joyshmitz/PLFM_RADAR/4_Schematics and Boards Layout/4_7_Production Files/Gerber_Patch_Antenna/BOM_Patch_Antenna.xlsx

Qty | Value | Device | Package | Parts | Description | MANUFACTURER_PART_NUMBER
11 | 142-0731-211 | 142-0731-211 | 1420731211 | J1, J2, J3, J4, J5, J6, J7, J8, J9, J10, J11, J12, J13, J14, J15, J17 | SMA Connector Jack, Female Socket 50 Ohms Through Hole Solder | 142-0731-211
