joyshmitz/PLFM_RADAR/4_Schematics and Boards Layout/4_7_Production Files/Gerber_freq_synth/BOM_Freq_Synth.xlsx

Qty | Value | Device | Package | Parts | Description | MANUFACTURER_PART_NUMBER
5 |  | L-EUL5650M | L5650M | L9, L10, L11, L12, L13 | INDUCTOR, European symbol | HI2220P601R-10
1 |  | PINHD-2X6 | 2X06 | JP1 | PIN HEADER | 87834-1211 (https://eu.mouser.com/ProductDetail/Molex/87834-1211?qs=kNSQ05%252BLZoDv7br%252B0FPisw%3D%3D)
1 |  | PINHD-2X7 | 2X07 | JP2 | PIN HEADER | 90130-1314 (https://eu.mouser.com/ProductDetail/Molex/90130-1314?qs=kEwmkoUtv7Q0tkiQKJqMSw%3D%3D)
28 | 0.1µF | C-EUC0201 | C0201 | C16, C18, C20, C22, C24, C26, C28, C30, C32, C34, C35, C36, C37, C41, C42, C43, C44, C64, C65, C66, C67, C87, C88, C90, C91, C4, C5, C7 | CAPACITOR, European symbol | CL03A104KP3NNNH
1 | 0.1µf | C-EUC0201 | C0201 | C92 | CAPACITOR, European symbol | CL03A104KP3NNNH
2 | 0.33µF | C-EUC0201 | C0201 | C2, C6 | CAPACITOR, European symbol | 0201X334M6R3CT (https://eu.mouser.com/ProductDetail/Walsin/0201X334M6R3CT?qs=iLbezkQI%252Bsj6TtN1Mk8apQ%3D%3D)
2 | 0.47µF | C-EUC0201 | C0201 | C9, C10 | CAPACITOR, European symbol | CL03A474KP3NNNC
1 | 0.47µf | C-EUC0201 | C0201 | C3 | CAPACITOR, European symbol | CL03A474KP3NNNC
3 | 0.65k | R-EU_R0201 | R0201 | R6, R8, R10 | RESISTOR, European symbol | CPF0201B649RE1 (https://eu.mouser.com/ProductDetail/TE-Connectivity-Holsworthy/CPF0201B649RE1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)
9 | 0R | R-EU_R0201 | R0201 | R5, R14, R15, R19, R20, R27, R28, R32, R33 | RESISTOR, European symbol | RCA02010000ZSEDSR
8 | 1.3nH | L-USL0201 | L0201 | L1, L2, L3, L4, L5, L6, L7, L8 | INDUCTOR, American symbol | LQP03HQ1N3W02D (https://eu.mouser.com/ProductDetail/Murata-Electronics/LQP03HQ1N3W02D?qs=B6kkDfuK7%2FBCgkEUu6f9mw%3D%3D)
1 | 1000pF | C-EUC0201 | C0201 | C8 | CAPACITOR, European symbol | CL03B102KA3NNNC
4 | 100R | R-EU_R0201 | R0201 | R1, R12, R13, R26 | RESISTOR, European symbol | RC0201FR-07100RL
2 | 10nF | C-EUC0201 | C0201 | C61, C84 | CAPACITOR, European symbol | 0201B103K250NT
3 | 10nF | C-EUC0402 | C0402 | C15, C17, C19 | CAPACITOR, European symbol | GRM1555CYA103GE01J (https://eu.mouser.com/ProductDetail/Murata-Electronics/GRM1555CYA103GE01J?qs=d0WKAl%252BL4KbA7gCogz12ew%3D%3D)
6 | 10pF | C-EUC0201 | C0201 | C1, C62, C63, C85, C86, C89 | CAPACITOR, European symbol | CL03C100JA3GNNC
5 | 10µF | C-EUC1210 | C1210 | C23, C27, C31, C45, C47 | CAPACITOR, European symbol | MBASU32MAB7106KPNA01 (https://eu.mouser.com/ProductDetail/TAIYO-YUDEN/MBASU32MAB7106KPNA01?qs=tlsG%2FOw5FFjbKuqA1IZNFA%3D%3D)
11 | 142-0731-211 | 142-0731-211 | 1420731211 | J1, J2, J5, J6, J7, J8, J9, J10, J11, J12, J13 | SMA Connector Jack, Female Socket 50 Ohms Through Hole Solder | 142-0731-211
6 | 1k | R-EU_R0201 | R0201 | R2, R3, R4, R7, R9, R11 | RESISTOR, European symbol | 1-2176072-2 (https://eu.mouser.com/ProductDetail/TE-Connectivity-Holsworthy/1-2176072-2?qs=TqB%2FzLOUcHJkUvL3%2FB9tYg%3D%3D)
10 | 1µF | C-EUC0201 | C0201 | C11, C12, C13, C14, C59, C68, C69, C70, C71, C82 | CAPACITOR, European symbol | CL03A105MQ3CSNH
8 | 200k | R-EU_R0201 | R0201 | R22, R23, R24, R25, R35, R36, R37, R38 | RESISTOR, European symbol | RE0201BRE07200KL (https://eu.mouser.com/ProductDetail/YAGEO/RE0201BRE07200KL)
6 | 22-23-2021 | 22-23-2021 | 22-23-2021 | X10, X11, X12, X13, X14, X15 | .100 (2.54mm) Center Header - 2 Pin" | 22-23-2021
3 | 22R | R-EU_R0201 | R0201 | R39, R40, R41 | RESISTOR, European symbol | RT0201FRE0722RL (https://eu.mouser.com/ProductDetail/YAGEO/RT0201FRE0722RL)
6 | 22µF | C-EUC1210 | C1210 | C21, C25, C29, C33, C46, C51 | CAPACITOR, European symbol | MAAST32MSB7226MPNA01 (https://eu.mouser.com/ProductDetail/TAIYO-YUDEN/MAAST32MSB7226MPNA01?qs=FmjOKN4Os876lp2kR04m7Q%3D%3D)
2 | 30R | R-EU_R0201 | R0201 | R17, R30 | RESISTOR, European symbol | ERJ-U01J300C (https://eu.mouser.com/ProductDetail/Panasonic/ERJ-U01J300C)
2 | 31pF | C-EUC0201 | C0201 | C60, C83 | CAPACITOR, European symbol | GCM0335C1H300FA16J (https://eu.mouser.com/ProductDetail/Murata-Electronics/GCM0335C1H300FA16J?qs=5aG0NVq1C4ze9%252Bgr8KZLTg%3D%3D)
2 | 330R | R-EU_R0201 | R0201 | R18, R31 | RESISTOR, European symbol | RC0201FR-7D330RL (https://eu.mouser.com/ProductDetail/YAGEO/RC0201FR-7D330RL?qs=sGAEpiMZZMtlubZbdhIBINSnPd898yDP6M5V2P2FozI%3D)
20 | 4.7µF | C-EUC0201 | C0201 | C38, C39, C40, C48, C49, C50, C55, C56, C57, C58, C72, C73, C74, C75, C76, C77, C78, C79, C80, C81 | CAPACITOR, European symbol | GRM035R60J475ME15D (https://eu.mouser.com/ProductDetail/Murata-Electronics/GRM035R60J475ME15D?qs=I53XXhTNm8vhFCgPvCZ%252BPQ%3D%3D)
2 | 500R | R-EU_R0201 | R0201 | R21, R34 | RESISTOR, European symbol | CPF0201B499RE1 (https://eu.mouser.com/ProductDetail/TE-Connectivity-Holsworthy/CPF0201B499RE1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)
2 | 931R | R-EU_R0201 | R0201 | R16, R29 | RESISTOR, European symbol | CRCW0201931RFKED (https://eu.mouser.com/ProductDetail/Vishay/CRCW0201931RFKED)
1 | AD9523BCPZ | AD9523BCPZ | QFN50P1000X1000X100-73N | IC1 | AD9523BCPZ, PLL Clock Driver Dual, 72-Pin LFCSP VQ | AD9523BCPZ
2 | ADF4382ABCCZ | ADF4382ABCCZ | CC-48-10_ADI | U1, U6 |  | ADF4382ABCCZ
4 | ATS1005-3DB-FD-T05 | ATS1005-3DB-FD-T05 | SMT_DB-FD-T05_SUS | U4, U5, U8, U10 |  | ATS1005-3DB-FD-T05
2 | CJT-T-P-HH-ST-TH1 | CJT-T-P-HH-ST-TH1 | CONN_CJT-T-P-XX-ST-TH1_SAI | J3, J4 |  | CJT-T-P-HH-ST-TH1
2 | CVHD-950-50.000 | CVHD-950-50.000 | SMD4_CVHD-950_CRX | X5, X6 |  | CVHD-950-50.000
1 | ECOC-2522-100.000-3HC | ECOC-2522-100.000-3HC | SMD5_ECOC-2522_25P4X22_ECS | X4 |  | ECOC-2522-100.000-3HC
4 | FBMH1608HL601-T | FBMH1608HL601-T | BEADC1608X90N | FB1, FB2, FB3, FB4 |  | FBMH1608HL601-T
2 | Green | LED-GREEN-0603-WE | LED-0603 | D1, D2 | Green SMD LED | KB EELP41.12-P1R2-36-3X4X-5-R18
4 | MTX2-143+ | MTX2-143+ | DQ1225_MNC | U2, U3, U7, U9 |  | MTX2-143+
