joyshmitz/PLFM_RADAR/4_Schematics and Boards Layout/4_7_Production Files/Gerber_Main_Board/BOM_Main_Board.xlsx

Qty | Value | Device | Package | Parts | Description | MANUFACTURER_PART_NUMBER
11 |  | L-EUL5650M | L5650M | L1, L11, L12, L13, L14, L15, L16, L17, L18, L21, L23 | INDUCTOR, European symbol | HI2220P601R-10
1 |  | MA10-2 | MA10-2 | SV1 | PIN HEADER | MA10-2
1 |  | PINHD-1X2 | 1X02 | JP20 | PIN HEADER | Do Not Put
11 |  | PINHD-1X3 | 1X03 | JP4, JP5, JP6, JP10, JP11, JP12, JP14, JP15, JP16, JP17, JP19 | PIN HEADER | Do Not Put
3 |  | PINHD-1X4 | 1X04 | JP8, JP9, JP18 | PIN HEADER | Do Not Put
1 |  | PINHD-1X6 | 1X06 | JP2 | PIN HEADER | Do Not Put
1 |  | PINHD-1X8 | 1X08 | JP7 | PIN HEADER | Do Not Put
1 |  | PINHD-2X4 | 2X04 | JP3 | PIN HEADER | Do Not Put
1 |  | PINHD-2X6 | 2X06 | JP1 | PIN HEADER | 87834-1211 (https://eu.mouser.com/ProductDetail/Molex/87834-1211?qs=kNSQ05%252BLZoDv7br%252B0FPisw%3D%3D)
1 |  | PINHD-2X7 | 2X07 | JP13 | PIN HEADER | 90130-1314 (https://eu.mouser.com/ProductDetail/Molex/90130-1314?qs=kEwmkoUtv7Q0tkiQKJqMSw%3D%3D)
1 |  | SJ2W | SJ_2 | SJ1 | SMD solder JUMPER | Do Not Put
71 | 0.1uF | CC0201 | C0201 | C1, C2, C4, C5, C6, C7, C8, C9, C10, C11, C12, C13, C14, C15, C16, C36, C38, C39, C41, C42, C44, C45, C46, C47, C51, C52, C53, C56, C67, C69, C74, C80, C82, C125, C131, C133, C138, C140, C146, C148, C159, C160, C162, C168, C170, C175, C188, C189, C190, C192, C193, C194, C195, C196, C201, C203, C208, C210, C215, C217, C222, C224, C229, C231, C236, C238, C243, C245, C250, C252, C293 | CAPACITOR, European symbol | CL03A104KP3NNNH
4 | 0.1uF | C-EUC0402 | C0402 | C48, C49, C57, C58 | CAPACITOR, European symbol | GRM155R71C104KA88D
6 | 0.1uF | CC0201 | C0201 | C277, C278, C295, C297, C299, C301 | CAPACITOR, European symbol | CL03A104KP3NNNH
1 | 0.2pF | C-EUC0201 | C0201 | C43 | CAPACITOR, European symbol | GJM0335C1ER20WB01D
13 | 0.47uF | CC0201 | C0201 | C110, C111, C112, C113, C155, C156, C157, C158, C179, C180, C181, C182, C291 | CAPACITOR, European symbol | CL03A474KP3NNNC
1 | 0.6pF | C-EUC0201 | C0201 | C54 | CAPACITOR, European symbol | GJM0335C1ER60WB01D
4 | 0R | RR0201 | R0201 | R18, R19, R34, R35 | RESISTOR, European symbol | RCA02010000ZSEDSR
12 | 100R | RR0201 | R0201 | R2, R3, R4, R5, R6, R7, R8, R9, R10, R11, R12, R173 | RESISTOR, European symbol | RC0201FR-07100RL
28 | 100nF | C-EUC0402 | C0402 | C76, C78, C258, C259, C260, C262, C264, C266, C313, C317, C320, C324, C327, C331, C334, C337, C339, C341, C342, C343, C344, C345, C346, C347, C348, C349, C350, C351 | CAPACITOR, European symbol | GRM155R71C104KA88D
24 | 100nF | CC0201 | C0201 | C24, C25, C26, C27, C28, C29, C30, C32, C33, C34, C35, C50, C256, C257, C279, C281, C298, C302, C303, C304, C305, C306, C307, C310 | CAPACITOR, European symbol | CL03A104KP3NNNH
34 | 100pF | CC0201 | C0201 | C66, C68, C73, C79, C81, C124, C130, C132, C137, C139, C145, C147, C152, C161, C167, C169, C174, C183, C200, C202, C207, C209, C214, C216, C221, C223, C228, C230, C235, C237, C242, C244, C249, C251 | CAPACITOR, European symbol | 0201CG101J500NT
2 | 103pF | CC0201 | C0201 | C60, C63 | CAPACITOR, European symbol | MLASU063SCG101JFNA01
1 | 106pF | CC0201 | C0201 | C141 | CAPACITOR, European symbol | GRM0335C1H111GA01D
4 | 107.3nH | LL0201 | L0201 | L22, L25, L26, L27 | INDUCTOR, European symbol | MLG0603PR11JTD25
9 | 10k | RR0201 | R0201 | R39, R40, R83, R84, R111, R123, R145, R151, R153 | RESISTOR, European symbol | AC0201FR-0710KL
16 | 10nF | CC0201 | C0201 | C102, C103, C104, C105, C106, C107, C114, C115, C116, C117, C118, C119, C120, C121, C122, C123 | CAPACITOR, European symbol | 0201B103K250NT
2 | 10uF | CC0201 | C0201 | C37, C40 | CAPACITOR, European symbol | KGM03DS60E106MH
12 | 10uF | C-EUC0805 | C0805 | C75, C77, C312, C316, C319, C323, C326, C330, C333, C336, C338, C340 | CAPACITOR, European symbol | GRM21BR61E106KA73L
1 | 115R | R-EU_R0201 | R0201 | R14 | RESISTOR, European symbol | RC0201FR-07115RL
2 | 12nH | LL0201 | L0201 | L2, L8 | INDUCTOR, European symbol | LQP02TN12NH02D
2 | 12pF | CC0201 | C0201 | C184, C185 | CAPACITOR, European symbol | GRM0335C1E120JA01D
37 | 142-0731-211 | 142-0731-211 | 1420731211 | J1, J18, J20, J22, J23, J24, J25, J26, J27, J28, J29, J30, J31, J32, J33, J34, J35, J36, J37, J38, J39, J40, J41, J42, J43, J44, J45, J46, J47, J48, J49, J50, J51, J52, J53, J54, J55 | SMA Connector Jack, Female Socket 50 Ohms Through Hole Solder | 142-0731-211
2 | 159nH | LL0201 | L0201 | L3, L4 | INDUCTOR, European symbol | LQP03TNR16H02D
2 | 18pF | CC0201 | C0201 | C272, C274 | CAPACITOR, European symbol | GRM0335C1E180JA01D
1 | 1k | R-EU_R0402 | R0402 | R37 | RESISTOR, European symbol | RC0402FR-071KL
49 | 1k | RR0201 | R0201 | R41, R43, R55, R56, R57, R58, R59, R61, R82, R85, R86, R87, R88, R93, R94, R99, R100, R101, R102, R107, R108, R109, R118, R124, R125, R126, R127, R128, R129, R130, R131, R133, R134, R135, R136, R137, R138, R139, R140, R144, R147, R148, R149, R167, R168, R169, R170, R171, R172 | RESISTOR, European symbol | 1-2176072-2 (https://eu.mouser.com/ProductDetail/TE-Connectivity-Holsworthy/1-2176072-2?qs=TqB%2FzLOUcHJkUvL3%2FB9tYg%3D%3D)
1 | 1k2_1% | RR0201 | R0201 | R60 | RESISTOR, European symbol | RC0201FR-071K2L
7 | 1nF | C-EUC0402 | C0402 | C314, C318, C321, C325, C328, C332, C335 | CAPACITOR, European symbol | CL03B102KA3NNNC
51 | 1pF | CC0201 | C0201 | C70, C71, C72, C83, C84, C85, C126, C128, C129, C134, C135, C136, C142, C143, C144, C149, C150, C151, C163, C165, C166, C171, C172, C173, C197, C198, C199, C204, C205, C206, C211, C212, C213, C218, C219, C220, C225, C226, C227, C232, C233, C234, C239, C240, C241, C246, C247, C248, C253, C254, C255 | CAPACITOR, European symbol | GJM0335C1E1R0WB01D
16 | 1uF | CC0201 | C0201 | C86, C87, C88, C89, C90, C91, C92, C93, C94, C95, C96, C97, C98, C99, C100, C101 | CAPACITOR, European symbol | CL03A105MQ3CSNH
3 | 1uF | CC0201 | C0201 | C276, C296, C300 | CAPACITOR, European symbol | CL03A105MQ3CSNH
1 | 2.2k | RR0201 | R0201 | R146 | RESISTOR, European symbol | RC0201FR-072K2L
3 | 2.2uF | CC0201 | C0201 | C22, C23, C164 | CAPACITOR, European symbol | GRM033R60J225ME47D
16 | 2.443k | RR0201 | R0201 | R89, R90, R91, R92, R95, R96, R97, R98, R103, R104, R105, R106, R119, R120, R121, R122 | RESISTOR, European symbol | RC0201FR-072K44L
1 | 2.7pF | C-EUC0402 | C0402 | C3 | CAPACITOR, European symbol | GJM1555C1H2R7WB01D
2 | 2.7pF | CC0201 | C0201 | C18, C19 | CAPACITOR, European symbol | GJM0335C1E2R7WB01D
4 | 200R | RR0201 | R0201 | R16, R17, R20, R21 | RESISTOR, European symbol | RC0201FR-07200RL
1 | 20k | R-EU_R0402 | R0402 | R38 | RESISTOR, European symbol | RC0402FR-0720KL
40 | 22-23-2021 | 22-23-2021 | 22-23-2021 | X1, X4, X5, X6, X7, X8, X9, X10, X11, X12, X13, X14, X15, X16, X17, X18, X19, X20, X21, X22, X24, X54, X55, X56, X_1, X_2, X_3, X_4, X_5, X_6, X_7, X_8, X_9, X_10, X_11, X_12, X_13, X_14, X_15, X_16 | .100 (2.54mm) Center Header - 2 Pin" | 22-23-2021
16 | 22-23-2031 | 22-23-2031 | 22-23-2031 | X3, X38, X39, X40, X41, X42, X43, X44, X45, X46, X47, X48, X49, X50, X51, X52 | .100 (2.54mm) Center Header - 3 Pin" | 22-23-2031
11 | 22.1k | RR0201 | R0201 | R154, R155, R156, R157, R158, R159, R160, R161, R162, R163, R164 | RESISTOR, European symbol | RC0201FR-0722K1L
13 | 22R | RR0201 | R0201 | R23, R24, R25, R26, R27, R28, R29, R30, R49, R51, R62, R63, R64 | RESISTOR, European symbol | RC0201FR-0722RL
2 | 22pF | CC0201 | C0201 | C308, C309 | CAPACITOR, European symbol | GRM0335C1E220JA01D
5 | 22uF | C-EUC1206 | C1206 | C283, C311, C315, C322, C329 | CAPACITOR, European symbol | GRM31CR61E226ME15L
2 | 24R | R-EU_R0402 | R0402 | R1, R13 | RESISTOR, European symbol | RC0402FR-0724RL
2 | 25R | RR0201 | R0201 | R165, R166 | RESISTOR, European symbol | RC0201FR-0725RL
4 | 25pF | CC0201 | C0201 | C64, C65, C268, C270 | CAPACITOR, European symbol | GRM0335C1E250JA01D
1 | 3.3uF | CC0201 | C0201 | C191 | CAPACITOR, European symbol | GRM033R60J335ME47D
2 | 32.8pF | CC0201 | C0201 | C59, C127 | CAPACITOR, European symbol | GJM0335C1E330JB01D
1 | 3k2 | RR0201 | R0201 | R33 | RESISTOR, European symbol | RC0201FR-073K2L
2 | 4.3k | R-EU_R0201 | R0201 | R15, R32 | RESISTOR, European symbol | RC0201FR-074K3L
2 | 4.3pF | CC0201 | C0201 | C20, C21 | CAPACITOR, European symbol | GJM0335C1E4R3WB01D
27 | 4.7k | RR0201 | R0201 | R42, R44, R45, R46, R47, R48, R50, R52, R53, R54, R65, R66, R67, R68, R69, R70, R71, R72, R73, R74, R75, R76, R77, R117, R141, R142, R143 | RESISTOR, European symbol | RC0201FR-074K7L
16 | 4.7nF | CC0201 | C0201 | C261, C263, C265, C267, C269, C271, C273, C275, C280, C282, C284, C286, C288, C290, C292, C294 | CAPACITOR, European symbol | GRM033R71E472KA88D
8 | 4.7uF | CC0201 | C0201 | C108, C109, C153, C154, C177, C178, C287, C289 | CAPACITOR, European symbol | GRM033R60J475ME47D
2 | 4.7uF 35V | 4.7UF-POLAR-EIA3528-35V-10%(TANT) | EIA3528 | C186, C187 |  | 595D475X9035B2T
1 | 47nF | CC0201 | C0201 | C31 | CAPACITOR, European symbol | GRM033R71E473KA88D
4 | 4.7uF | CC0201 | C0201 | C17, C55, C176, C285 | CAPACITOR, European symbol | CM03X5R475M06AH055
4 | 500R | RR0201 | R0201 | R110, R112, R113, R114 | RESISTOR, European symbol | RC0201FR-07500RL
3 | 50R | RR0201 | R0201 | R31, R115, R116 | RESISTOR, European symbol | RC0201FR-0750RL
4 | 50nH | LL0201 | L0201 | L9, L10, L24, L28 | INDUCTOR, European symbol | CE0603M-51NH
1 | 56R | R-EU_R0201 | R0201 | R22 | RESISTOR, European symbol | RC0201FR-0756RL
3 | 5R | RR0201 | R0201 | R132, R150, R152 | RESISTOR, European symbol | RC0201FR-075R1L
2 | 7.8pF | CC0201 | C0201 | C61, C62 | CAPACITOR, European symbol | GJM0335C1E7R8WB01D
1 | 830R | R-EU_R0402 | R0402 | R36 | RESISTOR, European symbol | RC0402FR-07830RL
4 | 840R | RR0201 | R0201 | R78, R79, R80, R81 | RESISTOR, European symbol | RC0201FR-07840RL
2 | AD8352ACPZ-R7 | AD8352ACPZ-R7 | CP_16_3_ADI | U4, U8 |  | AD8352ACPZ-R7
1 | AD9484BCPZ-500 | AD9484BCPZ-500 | CP_56_5_ADI | U1 |  | AD9484BCPZ-500
1 | AD9708AR | AD9708AR | RW_28_ADI | U3 |  | AD9708AR
4 | ADAR1000ACCZN | ADAR1000ACCZN | CC-88-1_ADI | ADAR1_, ADAR2_, ADAR3_, ADAR4_ |  | ADAR1000ACCZN
3 | ADS7830IPWR | ADS7830IPWR | PW16 | U10, U88, U89 |  | ADS7830IPWR
16 | ADTR1107ACCZ | ADTR1107ACCZ | CC-24-8_ADI | ADTR1107_1, ADTR1107_2, ADTR1107_3, ADTR1107_4, ADTR1107_5, ADTR1107_6, ADTR1107_7, ADTR1107_8, ADTR1107_9, ADTR1107_10, ADTR1107_11, ADTR1107_12, ADTR1107_13, ADTR1107_14, ADTR1107_15, ADTR1107_16 |  | ADTR1107ACCZ
1 | AT93C46A-10SQ-2.7 | AT93C46A-10SQ-2.7 | SOIC8 | IC1 | Three-wire Automotive Temperature Serial EEPROM 1K (64 x 16) | AT93C46A-10SQ-2.7
5 | BLM15HB121SN1 | BLM15HB121SN1 | L0402 | L5, L6, L7, L19, L20 | EMIFIL (R) Chip Ferrite Bead for GHz Noise | BLM15PE121SH1D
2 | BPF2 | BPF2 | BPF2 | U$2, U$3 |  | Not a component
4 | Blue | LED-BLUE0603 | LED-0603 | D2, D3, D4, D5 | Blue SMD LED | KB EELP41.12-P1R2-36-3X4X-5-R18
2 | CJT-T-P-HH-ST-TH1 | CJT-T-P-HH-ST-TH1 | CJTTPHHSTTH1 | J19, J21 | Conn Twinax F 0Hz to 4GHz 100Ohm Solder ST Thru-Hole Gold | CJT-T-P-HH-ST-TH1
2 | DAC5578SRGET | DAC5578SRGET | RGE24_2P7X2P7 | U7, U69 |  | DAC5578SRGET
1 | ECS-120-10-36B2-JTN-TR | CRYSTAL-12MHZ | CRYSTAL-SMD-2X2.5MM | Y1 | 12.0MHz Crystal | ECS-120-10-36B2-JTN-TR
1 | EP4RKU+ | EP4RKU+ | DG1677-2_MNC | U16 |  | EP4RKU+
1 | FT2232HQ | FT2232HQ | 64QFN_FT2232HQ_FTD | U6 |  | FT2232HQ
16 | INA241A3IDGKRDGK0008A-MFG | INA241A3IDGKRDGK0008A-MFG | DGK0008A-MFG | U11, U73, U74, U75, U76, U77, U78, U79, U80, U81, U82, U83, U84, U85, U86, U87 |  | INA241A3IDGKR
2 | LTC5552IUDBTRMPBF | LTC5552IUDBTRMPBF | UDB_12_ADI | U5, U13 |  | LTC5552IUDB#TRMPBF
17 | M3SWA2-34DR+ | M3SWA2-34DR+ | 16_QFN | RF_SW_1, RF_SW_2, RF_SW_3, RF_SW_4, RF_SW_5, RF_SW_6, RF_SW_7, RF_SW_8, RF_SW_9, RF_SW_10, RF_SW_11, RF_SW_12, RF_SW_13, RF_SW_14, RF_SW_15, RF_SW_16, U$1 |  | M3SWA2-34DR+
2 | MINI-USB-32005-201 | MINI-USB-32005-201 | 32005-201 | X2, X53 | MINI USB-B Conector | 10118192-0002LF
1 | MOMENTARY-SWITCH-SPST-SMD-4.6X2.8MM | MOMENTARY-SWITCH-SPST-SMD-4.6X2.8MM | TACTILE_SWITCH_SMD_4.6X2.8MM | S1 | Momentary Switch (Pushbutton) - SPST | EVQP0E07K
1 | MT25QL01GBBB8E12-0AUT | MT25QL01GBBB8E12-0AUT | BGA24_MT25QL_MRN | U9 |  | MT25QL01GBBB8E12-0AUT
1 | NX3215SA-32.768KHz | NX3225GD-8MHZ-STD-CRA-3 | XTAL_NX3225GD-8MHZ-STD-CRA-3_N | XTAL3 |  | NX3215SA-32.768K-STD-MUS-2
1 | NX3225GD-8MHZ-STD-CRA-3 | NX3225GD-8MHZ-STD-CRA-3 | XTAL_NX3225GD-8MHZ-STD-CRA-3_N | XTAL1 |  | NX3225GD-8MHZ-STD-CRA-3
4 | OPA4703EA/250 | OPA4703EA/250 | PW14 | OPA_1, OPA_2, OPA_3, OPA_4 |  | OPA4703EA/250
1 | STM32F746ZGT7 | STM32F746ZGT7 | LQFP-144_STM | U2 |  | STM32F746ZGT7
34 | SZMMSZ5232BT1G | SZMMSZ5232BT1G | SOD-123_ONS | U14, U15, U17, U37, U38, U39, U40, U41, U43, U44, U45, U46, U47, U48, U49, U50, U51, U52, U53, U54, U55, U56, U57, U58, U59, U60, U61, U62, U63, U64, U65, U66, U67, U68 |  | SZMMSZ5232BT1G
1 | XC7A50T-2FTG256I | XC7A50T-2FTG256I | BGA256C100P16X16_1700X1700X155 | U42 | Artix-7 Field Programmable Gate Array (FPGA) IC 170 2764800 52160 256-LBGA Check availability | XC7A50T-2FTG256I
