joyshmitz/PLFM_RADAR/4_Schematics and Boards Layout/4_7_Production Files/Gerber_PA/BOM_PA.xlsx

Qty | Value | Device | Package | Parts | Description | MANUFACTURER_PART_NUMBER | Manufacturer
1 |  | AK300/2 | AK300/2 | 22V | CONNECTOR | AK300/2
6 | 0.1µF | C-EUC0402 | C0402 | C2, C3, C6, C7, C8, C9 | CAPACITOR, European symbol | CL05B104KBD6PJC (https://eu.mouser.com/ProductDetail/Samsung-Electro-Mechanics/CL05B104KBD6PJC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)
6 | 0R | R-EU_R0402 | R0402 | R2, R3, R5, R7, R8, R9 | RESISTOR, European symbol | 5113 | Keystone Electronics (https://eu.mouser.com/manufacturer/keystone/)
1 | 0R | R-EU_R0603 | R0603 | R6 | RESISTOR, European symbol | RCA06030000ZSTA
2 | 10R | R-EU_R0402 | R0402 | R1, R4 | RESISTOR, European symbol | RN73H1ETTP10R1F50
3 | 10µF | C-EUC1206 | C1206 | C1, C4, C5 | CAPACITOR, European symbol | MLASU31LBB5106KTNA01
2 | 142-0731-211 | 142-0731-211 | 1420731211 | J1, J2 | SMA Connector Jack, Female Socket 50 Ohms Through Hole Solder | 142-0731-211
1 | 22-23-2021 | 22-23-2021 | 22-23-2021 | X2 | .100 (2.54mm) Center Header - 2 Pin" | 22-23-2021 | Molex
1 | 22-23-2031 | 22-23-2031 | 22-23-2031 | X3 | .100 (2.54mm) Center Header - 3 Pin" | 22-23-2031 | Molex
1 | 5mR | WSL2816R1000FEH | WSL2816_VIS | R10 | Shunt Resistor | WSL2816R1000FEH
1 | QPA2962_B | QPA2962_B | QPA2962_B | U$1 | RF Amplifier | QPA2962 | Qorvo
