joyshmitz/PLFM_RADAR/(list of files, cad)

Other CAD files:
8_Utils/Mechanical_Drawings/Heat_Sink_Main_Board.dwg
8_Utils/Mechanical_Drawings/SlipRing.dwg
8_Utils/Mechanical_Drawings/Waveguide.dwg
8_Utils/Mechanical_Drawings/Upper_Part_Waveguide.dwg
8_Utils/Mechanical_Drawings/Down_Part_Waveguide.dwg
8_Utils/Mechanical_Drawings/Heat_Sink_PA.dwg
