joyshmitz/PLFM_RADAR/4_Schematics and Boards Layout/4_6_Schematics/Antennas/Patch/8x16/Patch_Anetnna_16_8.sch

## EAGLE design 4_Schematics and Boards Layout/4_6_Schematics/Antennas/Patch/8x16/Patch_Anetnna_16_8.sch (2026-05-31)

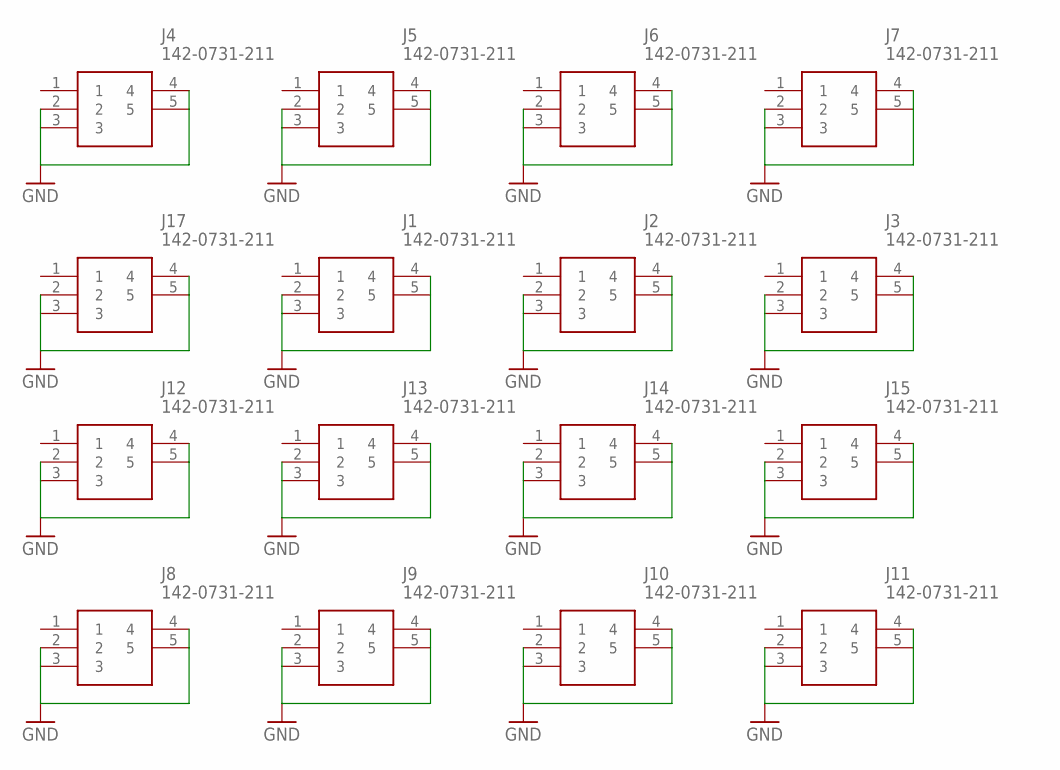
[picture p3: schematic Patch_Anetnna_16_8.sch]

Parts:
J1, J2, J3, J4, J5, J6, J7, J8, J9, J10, J11, J12, J13, J14, J15, J17: 142-0731-211; 1420731211

Connections:
GND: J1.2, J1.3, J1.4, J1.5, J2.2, J2.3, J2.4, J2.5, J3.2, J3.3, J3.4, J3.5, J4.2, J4.3, J4.4, J4.5, J5.2, J5.3, J5.4, J5.5, J6.2, J6.3, J6.4, J6.5, J7.2, J7.3, J7.4, J7.5, J8.2, J8.3, J8.4, J8.5, J9.2, J9.3, J9.4, J9.5, J10.2, J10.3, J10.4, J10.5, J11.2, J11.3, J11.4, J11.5, J12.2, J12.3, J12.4, J12.5, J13.2, J13.3, J13.4, J13.5, J14.2, J14.3, J14.4, J14.5, J15.2, J15.3, J15.4, J15.5, J17.2, J17.3, J17.4, J17.5
