joyshmitz/PLFM_RADAR/(commit log)

2026-04-07 fix(scripts,constraints): handle empty STATS properties in build summaries, fix 50T XDC DRC errors
    Build scripts (17-21): STATS.WNS/TNS/WHS/THS/TPWS from get_property can
    return empty strings in Vivado 2025.2 after write_bitstream auto-launch.
    Wrap in catch with N/A fallback. Guard all expr delta calculations and
    signoff comparisons with [string is double -strict] checks.
    XDC (xc7a50t_ftg256): Fix PLIO-9 by moving clk_120m_dac from C13 (N-type)
    to D13 (P-type MRCC) — clock inputs require P-type MRCC pin. Fix BIVC-1 by
    disabling DIFF_TERM on Bank 14 LVDS pairs to resolve VCCO conflict with
    single-ended adc_pwdn (LVCMOS33) on T5 — requires external termination.
    [xc7a50t_ftg256.xdc]
2026-04-07 fix(constraints): use LVDS (not LVDS_33) for 50T Bank 14 ADC inputs
    LVDS_33 is not a valid I/O standard on 7-series FPGAs. The correct
    standard for LVDS inputs in HR banks with VCCO != 2.5V is LVDS, which
    works with any VCCO for input-only buffers (IBUFDS). LVDS_25 requires
    VCCO=2.5V exactly.
    Note: the 50T FTG256 build still fails at placement due to pin overflow
    (113 ports vs 69 available pins) — this is a pre-existing package
    limitation unrelated to this fix.
    [xc7a50t_ftg256.xdc]
2026-04-12 fix: resolve 3 cross-layer bugs (status_words truncation, mode readback, buffer overread)
    Bug 1 (FPGA): status_words[0] was 37 bits (8+3+2+5+3+16), silently
    truncated to 32. Restructured to {0xFF, mode[1:0], stream[2:0],
    3'b000, threshold[15:0]} = 32 bits exactly. Fixed in both
    usb_data_interface_ft2232h.v and usb_data_interface.v.
    Bug 2 (Python): radar_mode extracted at bit 21 but was actually at
    bit 24 after truncation — always returned 0. Updated shift/mask in
    parse_status_packet() to match new layout (mode>>22, stream>>19).
    Bug 3 (STM32): parseFromUSB() minimum size check was 74 bytes but
    9 doubles + uint32 + markers = 82 bytes. Buffer overread on last
    fields when 74-81 bytes passed.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
    [RadarSettings.cpp, radar_protocol.py, test_cross_layer_contract.py, test_radar_dashboard.py, usb_data_interface.v, usb_data_interface_ft2232h.v]
2026-04-13 fix: playback state race condition, C-locale spinboxes, and Leaflet CDN loading
    - workers.py: Only emit playbackStateChanged on state transitions to
    prevent stale 'playing' signal from overwriting pause button text
    - dashboard.py: Force C locale on all QDoubleSpinBox instances so
    comma-decimal locales don't break numeric input; add missing
    'Saturation' legend label to AGC chart
    - map_widget.py: Enable LocalContentCanAccessRemoteUrls and set HTTP
    base URL so Leaflet CDN tiles/scripts load correctly in QtWebEngine
    [dashboard.py, map_widget.py, workers.py]
2026-04-16 chore(mcu): remove dead C-style adar1000 driver
    The firmware uses the C++ ADAR1000_Manager class exclusively. The C-style
    driver pair (adar1000.c, 693 LoC; adar1000.h, 294 LoC) has no external
    call sites:
    grep -rn "Adar_Set|Adar_Read|Adar_Write|Adar_Soft" 9_Firmware
    grep -rn "AdarDevice|AdarBiasCurrents|AdarDeviceInfo" 9_Firmware
    Both return hits only inside adar1000.c/h themselves. ADAR1000_Manager.h
    has its own copies of REG_CH1_*, REG_INTERFACE_CONFIG_A, etc. and does
    not include adar1000.h. main.cpp had a lone #include "adar1000.h" but
    referenced no symbols from it; the REG_* macros it uses resolve through
    ADAR1000_Manager.h on the next line.
    No behaviour change: the deleted code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
    [main.cpp]
2026-04-17 test(cross-layer): enforce status word field positions match Verilog concat layout
    Tier-1 had only one explicit per-field assertion (radar_mode at lsb=22).
    The Tier-2 round-trip uses the same Python parser as oracle for status
    word decoding, so a coupled Verilog+Python bit-position shift in
    status_words[0]/[3]/[4]/[5] passes Tier-2 silently — only [1] and [2]
    have an independent raw-byte check in tb_cross_layer_ft2232h.v.
    Add an independent static check that walks each Verilog status_words[N]
    concatenation MSB->LSB via count_concat_bits, computes (word_idx, lsb,
    width) for every named payload fragment, drops literal padding, and
    compares against every field parse_status_packet() extracts.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
2026-04-18 fix(adar1000): correct 1-based channel indexing in setters (issue #90)
    The four channel-indexed ADAR1000 setters (adarSetRxPhase, adarSetTxPhase,
    adarSetRxVgaGain, adarSetTxVgaGain) computed their register offset as
    `(channel & 0x03) * stride`, which silently aliased CH4 (channel=4 ->
    mask=0) onto CH1 and shifted CH1..CH3 by one. The API contract (1-based
    CH1..CH4) is documented in ADAR1000_AGC.cpp:76 and matches the ADI
    datasheet; every existing caller already passes `ch + 1`.
    Fix: subtract 1 before masking -- `((channel - 1) & 0x03) * stride` --
    and reject `channel < 1 || channel > 4` early with a DIAG message so a
    future stale 0-based caller fails loudly instead of writing to CH4.
    Adds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
    [ADAR1000_Manager.cpp, test_cross_layer_contract.py]
2026-04-19 fix(v7): align live host-DSP units with replay path
    Use WaveformConfig for live range/velocity conversion in RadarDataWorker
    and add headless AST-based regression checks in test_v7.py.
    Before: RadarDataWorker._run_host_dsp used RadarSettings.velocity_resolution
    (default 1.0 in models.py:113), while ReplayWorker used WaveformConfig
    (~5.343 m/s/bin). Live GUI under-reported velocity by factor ~5.34x.
    Fix: local WaveformConfig() in _run_host_dsp, mirroring ReplayWorker
    pattern. Doppler center derived from frame shape, matching processing.py:520.
    Test: TestLiveReplayPhysicalUnitsParity in test_v7.py uses ast.parse on
    workers.py (no v7.workers import, headless-CI-safe despite PyQt6 dep)
    and as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
    [test_v7.py, workers.py]
2026-04-20 fix(v7): store WaveformConfig on self; add set_waveform parity; fix magic 32
    - Move WaveformConfig() from per-frame local in _run_host_dsp to
    self._waveform in __init__, mirroring ReplayWorker pattern.
    - Add set_waveform() to RadarDataWorker for injection symmetry with
    ReplayWorker.set_waveform() — live path is now configurable.
    - Replace hardcoded fallback 32 with self._waveform.n_doppler_bins.
    - Update AST contract tests: WaveformConfig() check moves to __init__
    parse; attribute chains updated from ("wf", ...) to
    ("self", "_waveform", ...) to match renamed accessor.
    [test_v7.py, workers.py]
2026-04-20 fix(v7): wrap long n_doppler fallback line for ruff E501
    Line exceeded 100-char limit; wrap with parentheses to stay within
    project line-length setting.
    [workers.py]
2026-04-20 fix(fpga): widen AGC gain arithmetic to 6-bit to prevent wraparound
    5-bit signed subtraction in clamp_gain wrapped for agc_attack >= 10 or
    agc_decay >= 9 when |agc_gain| + step > 16, inverting gain polarity
    instead of clamping — e.g. gain=-7, attack=10 produced +7 (max amplify)
    rather than -7 (max attenuate), causing ADC saturation on strong returns.
    Widen clamp_gain input to [5:0] and sign-extend both operands to 6 bits
    ({agc_gain[3],agc_gain[3],agc_gain} and {2'b00,agc_attack/decay}),
    covering the full [-22,+22] range before clamping. Default attack/decay
    values (1-4) are unaffected; behaviour changes only for values >= 10/9.
    [rx_gain_control.v]
2026-04-20 fix(mcu): volatile emergency state + AGC holdoff zero-guard (closes #83)
    Bug 1 (main.cpp:630): system_emergency_state lacked volatile. Under -O1+
    the compiler is permitted to hoist the read outside the blink loop, making
    while (system_emergency_state) unconditionally infinite. Once entered, the
    only escape was the 4 s IWDG timeout — which resets the MCU and
    re-energizes the PA rails that Emergency_Stop() explicitly cut. Marking the
    variable volatile forces a memory read on every iteration so an external
    clear (ISR, USB command, manual reset) can break the loop correctly.
    Bug 2 (ADAR1000_AGC.cpp:59): holdoff_frames is a public uint8_t; if a
    caller sets it to 0, the condition holdoff_counte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
    [ADAR1000_AGC.cpp, main.cpp]
2026-04-20 fix(mcu): add FAULT_ACK command to clear system_emergency_state via USB (closes #83)
    The volatile fix in the companion PR (#118) makes the safe-mode blink loop
    escapable in principle, but no firmware path existed to actually clear
    system_emergency_state at runtime — hardware reset was the only exit, which
    fires the IWDG and re-energises the PA rails that Emergency_Stop() cut.
    This change adds a FAULT_ACK command (opcode 0x40): the host sends an exact
    4-byte CDC packet [0x40, 0x00, 0x00, 0x00]; USBHandler detects it regardless
    of USB state and sets fault_ack_received; the blink loop checks the flag each
    250 ms iteration and clears system_emergency_state, allowing a controlled
    operator-ackn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
    [USBHandler.cpp, USBHandler.h, contract_parser.py, main.cpp, radar_protocol.py]
2026-04-24 fix: three utility bugs in compare, LUT, and triangular waveform scripts
    - compare.py: capture max_abs_error return values and add pass/fail
    check (was silently discarded, missing outlier detection)
    - LUT.py: replace no-op pass with actual print of 8-bit Verilog values
    - Gen_Triangular.py: fix plt.plot(2*n, y) -> plt.plot(t, x) scalar vs
    array bug that produced broken time-domain plot
