joyshmitz/PLFM_RADAR/(notices)

Notices in the files:
9_Firmware/9_1_Microcontroller/9_1_3_C_Cpp_Code/main.cpp:
Copyright (c) 2025 STMicroelectronics.
All rights reserved.
This software is licensed under terms that can be found in the LICENSE file
README.md:
License: MIT
Hardware: CERN-OHL-P
